kbd0/xwhatsit-solenoid/README.md

# xwhatsit-solenoid

Combination of purdeaandrei's universal xwhatsit: https://github.com/purdeaandrei/SMDModelFController

and solenoid driver: https://github.com/purdeaandrei/SolenoidDriver

into one PCB.
 
Not compatible with 3178
 
Original licensure holds
