kbd0/xwhatsit-solenoid/SMDModelF.kicad_pcb

## KiCad design SMDModelF.kicad_pcb (2023-03-30)

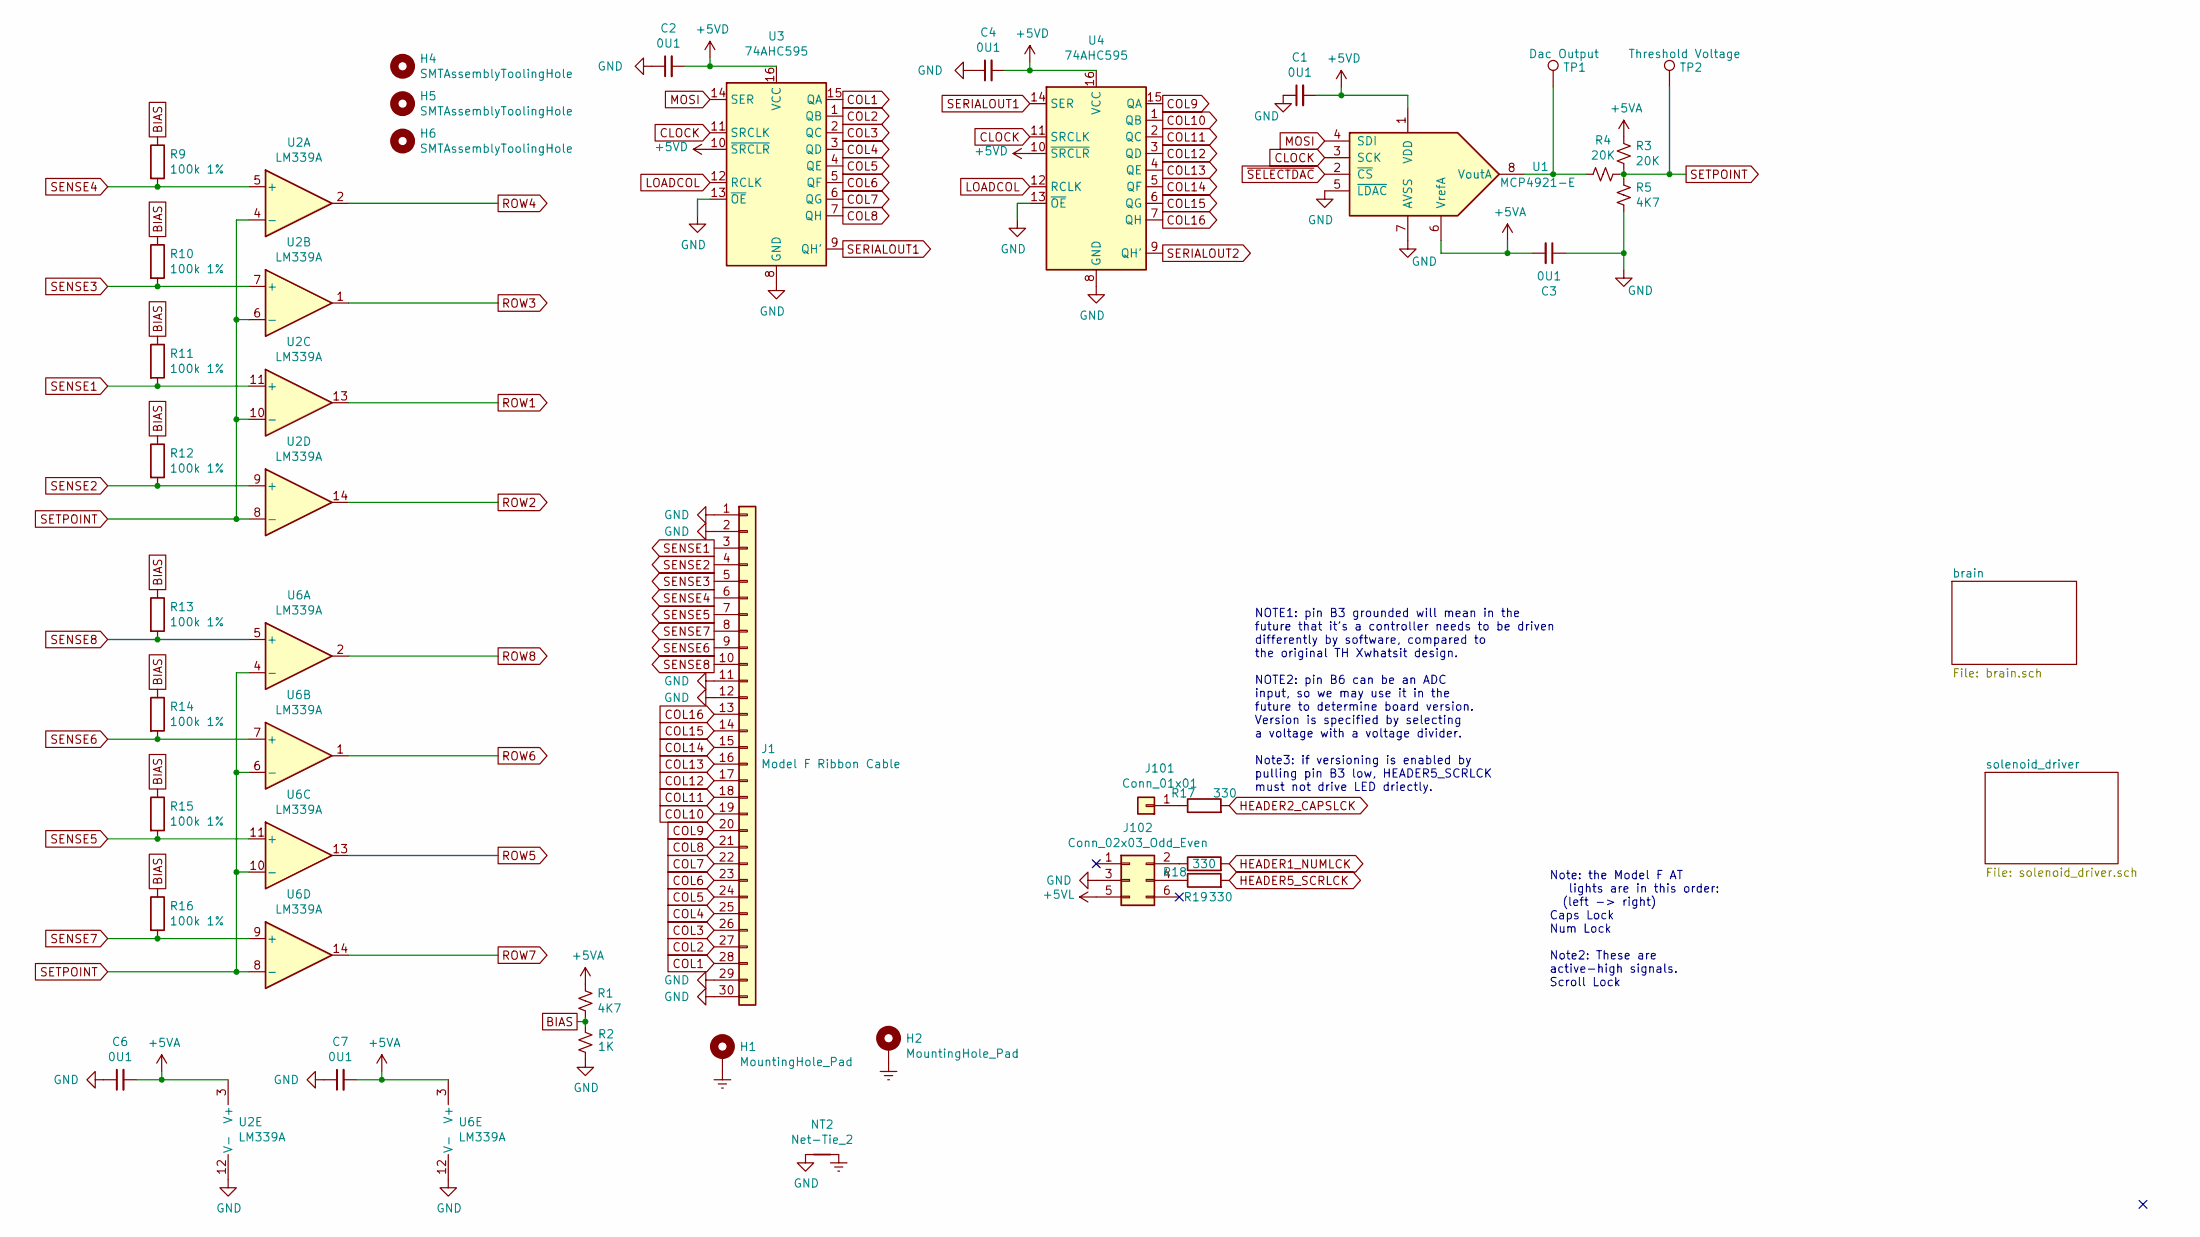
[picture p1: schematic SMDModelF.sch, SMD Model F Controller Based on TH Xwhatsit]

Parts:
C1, C2, C3, C4, C6, C7: 0U1; C_0805_2012Metric_Pad1.15x1.40mm_HandSolder; LCSC C49678
H1: MountingHole_Pad; ModelF_new_mounting_hole_left
H2: MountingHole_Pad; ModelF_new_mounting_hole_right
H4, H5, H6: SMTAssemblyToolingHole; tooling_hole
J1: Model F Ribbon Cable; Model_F_3.96mm_pitch_footprint
J101: Conn_01x01; PinHeader_1x01_P2.54mm_Horizontal; LCSC C2883798
J102: Conn_02x03_Odd_Even; PinHeader_2x03_P2.54mm_Horizontal; LCSC C239334
NT2: Net-Tie_2; NetTie-2_SMD_Pad0.5mm
R1, R5: 4K7; R_0805_2012Metric_Pad1.15x1.40mm_HandSolder; LCSC C17673
R2: 1K; R_0805_2012Metric_Pad1.15x1.40mm_HandSolder; LCSC C17513
R3, R4: 20K; R_0805_2012Metric_Pad1.15x1.40mm_HandSolder; LCSC C4328
R9, R10, R11, R12, R13, R14, R15, R16: 100k 1%; R_0805_2012Metric_Pad1.15x1.40mm_HandSolder; LCSC C17407
R17, R18, R19: 330; R_0805_2012Metric_Pad1.15x1.40mm_HandSolder; LCSC C17630
TP1: Dac Output; TestPoint_Pad_D1.0mm
TP2: Threshold Voltage; TestPoint_Pad_D1.0mm
U1: MCP4921-E; SOIC-8_3.9x4.9mm_P1.27mm; LCSC C43499
U2, U6: LM339A; SOIC-14_3.9x8.7mm_P1.27mm; LCSC C74559
U3, U4: 74AHC595; SOIC-16_3.9x9.9mm_P1.27mm; LCSC C5520

Connections:
+5VA: C3.2, C6.2, C7.2, R1.1, R3.2, U1.6 (VrefA), U2.3 (V+), U6.3 (V+); also elsewhere on the board
+5VD: C1.2, C2.2, C4.2, U1.1 (VDD), U3.10 (~SRCLR), U3.16 (VCC), U4.10 (~SRCLR), U4.16 (VCC); also elsewhere on the board
BIAS: R1.2, R2.2, R9.1, R10.1, R11.1, R12.1, R13.1, R14.1, R15.1, R16.1
CLOCK: U1.3 (SCK), U3.11 (SRCLK), U4.11 (SRCLK); also elsewhere on the board
COL1: J1.28, U3.15 (QA)
COL2: J1.27, U3.1 (QB)
COL3: J1.26, U3.2 (QC)
COL4: J1.25, U3.3 (QD)
COL5: J1.24, U3.4 (QE)
COL6: J1.23, U3.5 (QF)
COL7: J1.22, U3.6 (QG)
COL8: J1.21, U3.7 (QH)
COL9: J1.20, U4.15 (QA)
COL10: J1.19, U4.1 (QB)
COL11: J1.18, U4.2 (QC)
COL12: J1.17, U4.3 (QD)
COL13: J1.16, U4.4 (QE)
COL14: J1.15, U4.5 (QF)
COL15: J1.14, U4.6 (QG)
COL16: J1.13, U4.7 (QH)
Earth: H1.1, H2.1, NT2.2; also elsewhere on the board
GND: C1.1, C2.1, C3.1, C4.1, C6.1, C7.1, J1.1, J1.2, J1.11, J1.12, J1.29, J1.30, J102.3, NT2.1, R2.1, R5.1, U1.5 (~LDAC~), U1.7 (AVSS), U2.12 (V-), U3.8 (GND), U3.13 (~OE), U4.8 (GND), U4.13 (~OE), U6.12 (V-); also elsewhere on the board
HEADER1_NUMLCK: R18.2; also elsewhere on the board
HEADER2_CAPSLCK: R17.2; also elsewhere on the board
HEADER5_SCRLCK: R19.2; also elsewhere on the board
LOADCOL: U3.12 (RCLK), U4.12 (RCLK); also elsewhere on the board
MOSI: U1.4 (SDI), U3.14 (SER); also elsewhere on the board
unnamed 43: J101.1, R17.1; also elsewhere on the board
unnamed 45: J102.2, R18.1; also elsewhere on the board
unnamed 46: J102.4, R19.1; also elsewhere on the board
unnamed: R4.2, TP1.1, U1.8 (VoutA)
ROW1: U2.13; also elsewhere on the board
ROW2: U2.14; also elsewhere on the board
ROW3: U2.1; also elsewhere on the board
ROW4: U2.2; also elsewhere on the board
ROW5: U6.13; also elsewhere on the board
ROW6: U6.1; also elsewhere on the board
ROW7: U6.14; also elsewhere on the board
ROW8: U6.2; also elsewhere on the board
SENSE1: J1.3, R11.2, U2.11 (+)
SENSE2: J1.4, R12.2, U2.9 (+)
SENSE3: J1.5, R10.2, U2.7 (+)
SENSE4: J1.6, R9.2, U2.5 (+)
SENSE5: J1.7, R15.2, U6.11 (+)
SENSE6: J1.9, R14.2, U6.7 (+)
SENSE7: J1.8, R16.2, U6.9 (+)
SENSE8: J1.10, R13.2, U6.5 (+)
SERIALOUT1: U3.9 (QH'), U4.14 (SER)
SERIALOUT2: U4.9 (QH')
SETPOINT: R3.1, R4.1, R5.2, TP2.1, U2.4 (-), U2.6 (-), U2.8 (-), U2.10 (-), U6.4 (-), U6.6 (-), U6.8 (-), U6.10 (-)
~SELECTDAC: U1.2 (~CS~); also elsewhere on the board

Notes on the sheet:
Note: the Model F AT lights are in this order: (left -> right) Caps Lock Num Lock Note2: These are active-high signals. Scroll Lock
NOTE1: pin B3 grounded will mean in the future that it's a controller needs to be driven differently by software, compared to the original TH Xwhatsit design. NOTE2: pin B6 can be an ADC input, so we may use it in the future to determine board version. Version is specified by selecting a voltage wi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

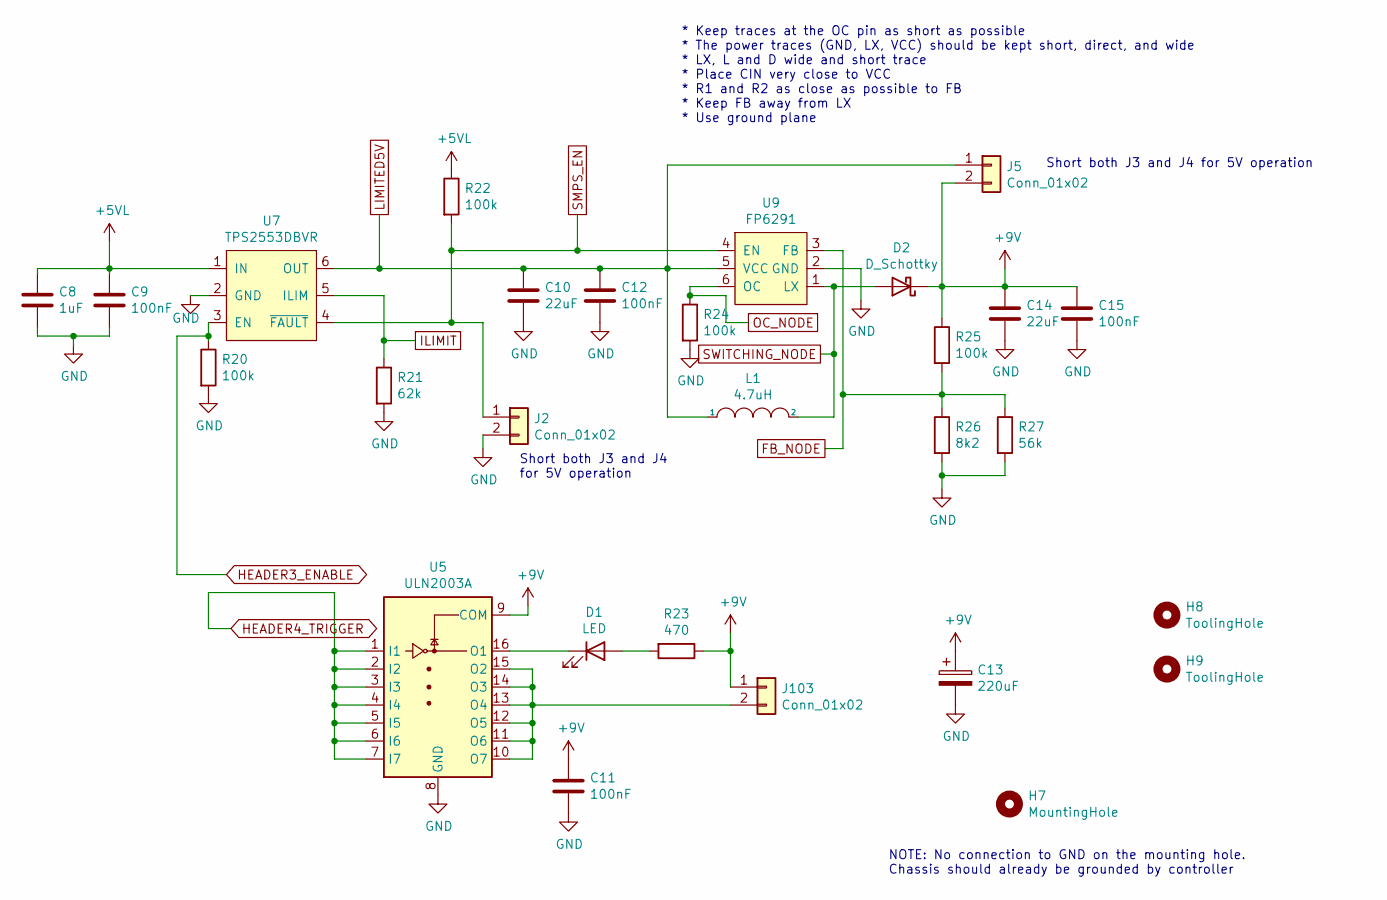
[picture p2: schematic solenoid_driver.sch]

Parts:
C8: 1uF; C_0805_2012Metric_Pad1.15x1.40mm_HandSolder; LCSC C28323
C9, C11, C12, C15: 100nF; C_0805_2012Metric_Pad1.15x1.40mm_HandSolder; LCSC C49678
C10, C14: 22uF; C_0603_1608Metric_Pad1.05x0.95mm_HandSolder; LCSC C45783
C13: 220uF; CP_Elec_6.3x7.7; LCSC C127327
D1: LED; LED_0805_2012Metric_Pad1.15x1.40mm_HandSolder; LCSC C2296
D2: D_Schottky; D_SMA; LCSC C2480
H7: MountingHole; MountingHole_4mm_Pad
H8, H9: ToolingHole; tooling_hole
J2, J5: Conn_01x02; shortable
J103: Conn_01x02; PinHeader_1x02_P2.54mm_Horizontal; LCSC C2905424
L1: 4.7uH; footprint_for_MWSA0503_HANDSOLD; LCSC C408410
R20, R22, R24, R25: 100k; R_0805_2012Metric_Pad1.15x1.40mm_HandSolder; LCSC C17407
R21: 62k; R_0805_2012Metric_Pad1.15x1.40mm_HandSolder; LCSC C17783
R23: 470; R_0805_2012Metric_Pad1.15x1.40mm_HandSolder; LCSC C17710
R26: 8k2; R_0805_2012Metric_Pad1.15x1.40mm_HandSolder; LCSC C17828
R27: 56k; R_0805_2012Metric_Pad1.15x1.40mm_HandSolder; LCSC C17756
U5: ULN2003A; SOIC-16_3.9x9.9mm_P1.27mm; LCSC C7512
U7: TPS2553DBVR; SOT-23-6_Handsoldering; LCSC C55266
U9: FP6291; SOT-23-6_Handsoldering; LCSC C18701

Connections:
+5VL: C8.1, C9.1, R22.1, U7.1 (IN); also elsewhere on the board
+9V: C11.1, C13.1, C14.1, C15.1, D2.1 (K), J5.2, J103.1, R23.1, R25.1, U5.9 (COM); also elsewhere on the board
FB_NODE: R25.2, R26.1, R27.1, U9.3 (FB)
GND: C8.2, C9.2, C10.2, C11.2, C12.2, C13.2, C14.2, C15.2, J2.2, R20.2, R21.2, R24.2, R26.2, R27.2, U5.8 (GND), U7.2 (GND), U9.2 (GND); also elsewhere on the board
HEADER3_ENABLE: R20.1, U7.3 (EN); also elsewhere on the board
HEADER4_TRIGGER: U5.1 (I1), U5.2 (I2), U5.3 (I3), U5.4 (I4), U5.5 (I5), U5.6 (I6), U5.7 (I7); also elsewhere on the board
ILIMIT: R21.1, U7.5 (ILIM)
LIMITED5V: C10.1, C12.1, J5.1, L1.1, U7.6 (OUT), U9.5 (VCC)
unnamed: D1.1 (K), U5.16 (O1)
unnamed: D1.2 (A), R23.2
unnamed 42: J103.2, U5.10 (O7), U5.11 (O6), U5.12 (O5), U5.13 (O4), U5.14 (O3), U5.15 (O2); also elsewhere on the board
OC_NODE: R24.1, U9.6 (OC)
SMPS_EN: J2.1, R22.2, U7.4 (~FAULT), U9.4 (EN)
SWITCHING_NODE: D2.2 (A), L1.2, U9.1 (LX)

Notes on the sheet:
* Keep traces at the OC pin as short as possible * The power traces (GND, LX, VCC) should be kept short, direct, and wide * LX, L and D wide and short trace * Place CIN very close to VCC * R1 and R2 as close as possible to FB * Keep FB away from LX * Use ground plane
NOTE: No connection to GND on the mounting hole. Chassis should already be grounded by controller
Short both J3 and J4 for 5V operation
Short both J3 and J4 for 5V operation

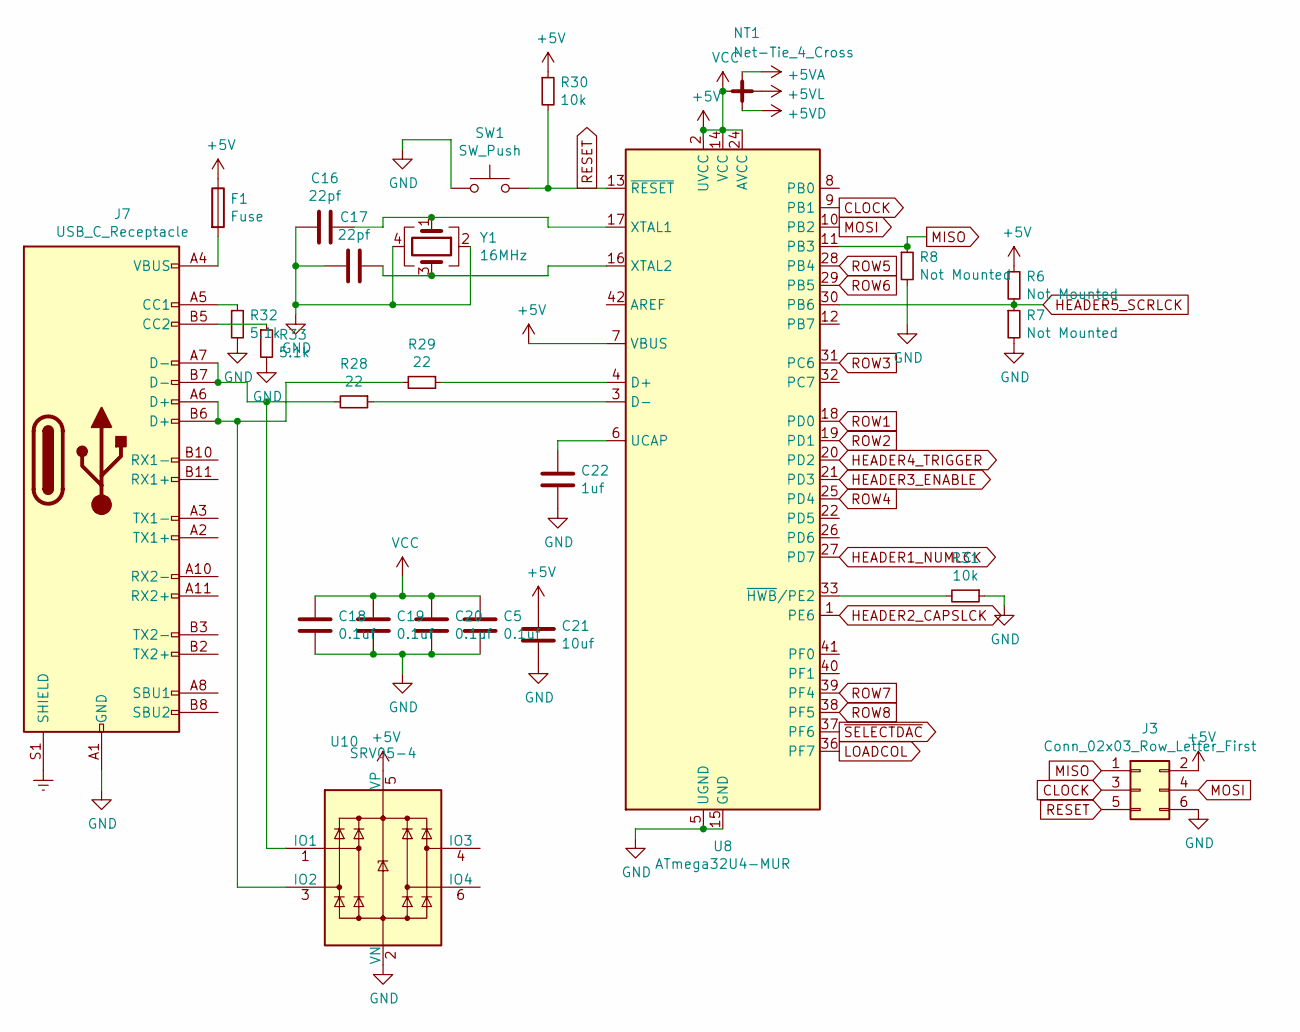
[picture p3: schematic brain.sch]

Parts:
C5, C18, C19, C20: 0.1uf; C_0805_2012Metric_Pad1.15x1.40mm_HandSolder
C16, C17: 22pf; C_0805_2012Metric_Pad1.15x1.40mm_HandSolder
C21: 10uf; C_0805_2012Metric_Pad1.15x1.40mm_HandSolder
C22: 1uf; C_0805_2012Metric_Pad1.15x1.40mm_HandSolder
F1: Fuse; Fuse_0805_2012Metric_Castellated
J3: Conn_02x03_Row_Letter_First; PinHeader_2x03_P2.54mm_Vertical
J7: USB_C_Receptacle; USB_C_Receptacle_XKB_U262-16XN-4BVC11
NT1: Net-Tie_4_Cross; NetTie-2_THT_Pad1.0mm
R6, R7, R8: Not Mounted; R_0805_2012Metric_Pad1.15x1.40mm_HandSolder
R28, R29: 22; R_0805_2012Metric_Pad1.15x1.40mm_HandSolder
R30, R31: 10k; R_0805_2012Metric_Pad1.15x1.40mm_HandSolder
R32, R33: 5.1k; R_0805_2012Metric
SW1: SW_Push; SW_TS-1187A-B-A-B
U8: ATmega32U4-MUR; TQFP-44_10x10mm_P0.8mm
U10: SRV05-4; SOT-23-6
Y1: 16MHz; OSC_X322516MLB4SI

Connections:
+5V: C5.2, C18.2, C19.2, C20.2, C21.2, F1.1, J3.2, NT1.1, R6.1, R30.1, U8.2 (UVCC), U8.7 (VBUS), U8.14 (VCC), U8.24 (AVCC), U8.34 (VCC), U8.44 (AVCC), U10.5 (VP)
+5VA: NT1.3; also elsewhere on the board
+5VD: NT1.4; also elsewhere on the board
+5VL: NT1.2; also elsewhere on the board
CLOCK: J3.3, U8.9 (PB1); also elsewhere on the board
Earth: J7.S1 (SHIELD); also elsewhere on the board
GND: C5.1, C16.2, C17.2, C18.1, C19.1, C20.1, C21.1, C22.1, J3.6, J7.A1 (GND), J7.A12 (GND), J7.B1 (GND), J7.B12 (GND), R7.2, R8.2, R31.1, R32.2, R33.2, SW1.1, U8.5 (UGND), U8.15 (GND), U8.23 (GND), U8.35 (GND), U8.43 (GND), U8.45 (GND), U10.2 (VN), Y1.2, Y1.4; also elsewhere on the board
HEADER1_NUMLCK: U8.27 (PD7); also elsewhere on the board
HEADER2_CAPSLCK: U8.1 (PE6); also elsewhere on the board
HEADER3_ENABLE: U8.21 (PD3); also elsewhere on the board
HEADER4_TRIGGER: U8.20 (PD2); also elsewhere on the board
HEADER5_SCRLCK: R6.2, R7.1, U8.30 (PB6); also elsewhere on the board
LOADCOL: U8.36 (PF7); also elsewhere on the board
MISO: J3.1, R8.1, U8.11 (PB3)
MOSI: J3.4, U8.10 (PB2); also elsewhere on the board
unnamed: C16.1, U8.17 (XTAL1), Y1.1
unnamed: C17.1, U8.16 (XTAL2), Y1.3
unnamed: C22.2, U8.6 (UCAP)
unnamed: F1.2, J7.A4 (VBUS), J7.A9 (VBUS), J7.B4 (VBUS), J7.B9 (VBUS)
unnamed: J7.A5 (CC1), R32.1
unnamed: J7.A6 (D+), J7.B6 (D+), R29.2, U10.3 (IO2)
unnamed: J7.A7 (D-), J7.B7 (D-), R28.2, U10.1 (IO1)
unnamed: J7.B5 (CC2), R33.1
unnamed: R28.1, U8.3 (D-)
unnamed: R29.1, U8.4 (D+)
unnamed: R31.2, U8.33 (~HWB~/PE2)
RESET: J3.5, R30.2, SW1.2, U8.13 (~RESET)
ROW1: U8.18 (PD0); also elsewhere on the board
ROW2: U8.19 (PD1); also elsewhere on the board
ROW3: U8.31 (PC6); also elsewhere on the board
ROW4: U8.25 (PD4); also elsewhere on the board
ROW5: U8.28 (PB4); also elsewhere on the board
ROW6: U8.29 (PB5); also elsewhere on the board
ROW7: U8.39 (PF4); also elsewhere on the board
ROW8: U8.38 (PF5); also elsewhere on the board
~SELECTDAC: U8.37 (PF6); also elsewhere on the board

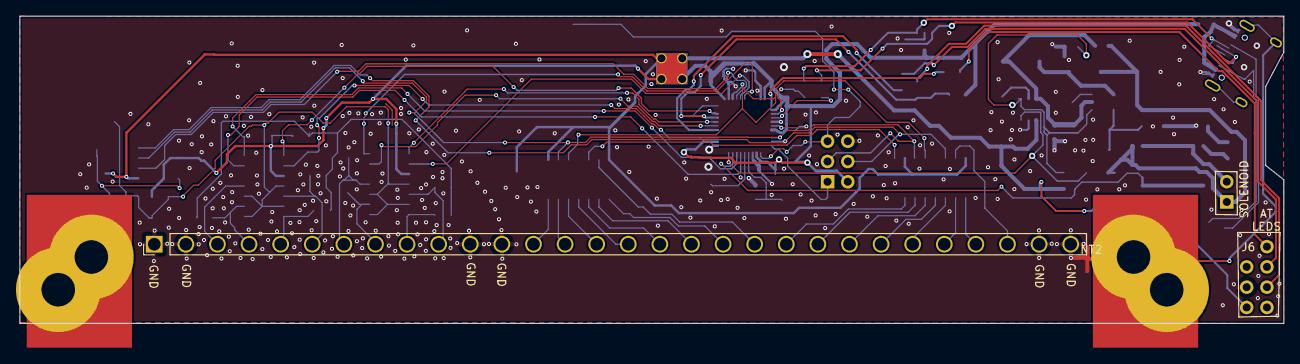
[picture p4: board SMDModelF.kicad_pcb from above]

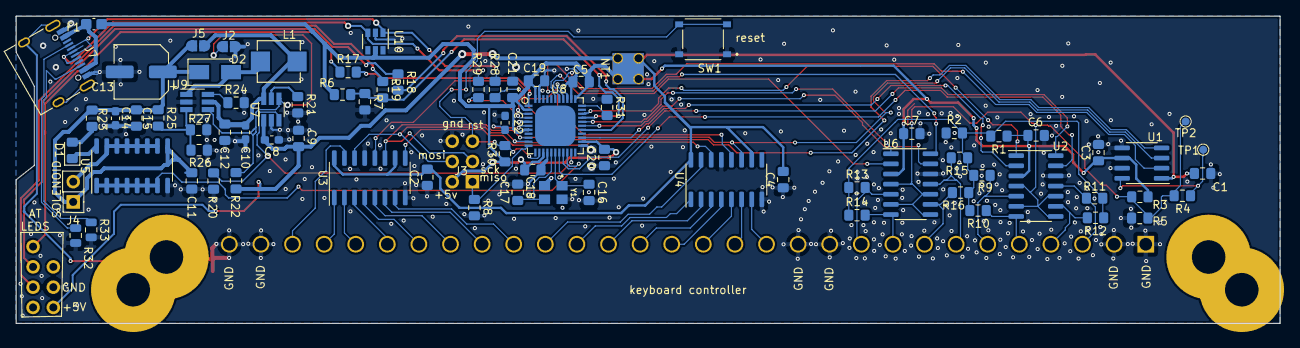
[picture p5: board SMDModelF.kicad_pcb from below]

Board: 2 copper layers, 158.4 x 38.5 mm, 84 parts (79 on the bottom side), 77 nets.

Other parts of the board:
J4: Conn_01x02; PinHeader_1x02_P2.54mm_Vertical
J6: MODEL F AT LOCKLIGHTS HEADER; FAT_LockLightsConnector

Their connections:
+5VL: J6.7; also elsewhere on the board
+9V: J4.1; also elsewhere on the board
GND: J6.5; also elsewhere on the board
unnamed 42: J4.2; also elsewhere on the board
unnamed 43: J6.2; also elsewhere on the board
unnamed 45: J6.4; also elsewhere on the board
unnamed 46: J6.6; also elsewhere on the board
