kbd0/xwhatsit-solenoid/(notices)

Notices in the files:
SMDModelF.sch:
Licenced under CERN OHL Version 1.2
SMDModelF.kicad_pcb:
Copyright Rainy Day Plans.
This documentation describes Open Hardware and is licensed under the
CERN OHL v. 1.2.
